abdelmojeb/TangramFP_course_project_and_thesis/Thesis/Screenshot 2025-09-23 221511.png

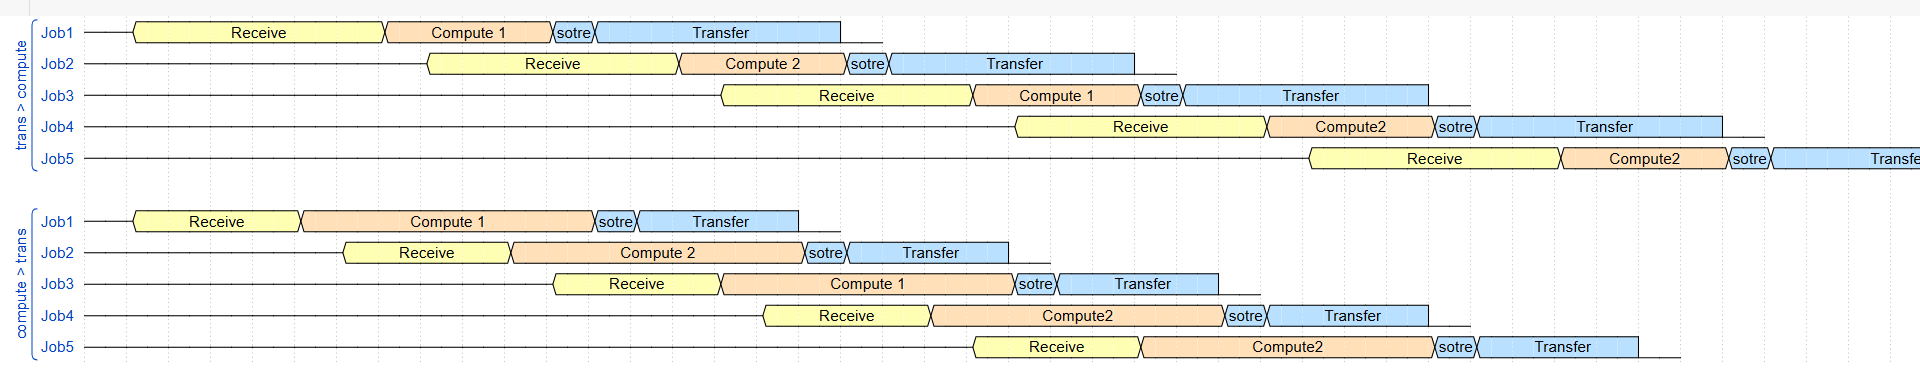
Thesis/Screenshot 2025-09-23 221511.png
