abdelmojeb/TangramFP_course_project_and_thesis/ATES_course/HW_implementation/MAC_results.txt

Time first input: 15000 ps
Time second input: 25000 ps
Time: 35000 ps
clock at: 35000 ps
a:= -1.465743e+12
b:= -1.643155e-32
c:= -1.806668e-20
success 1
actual:= 6.017749e-21
expected:= 6.017749e-21
a: 00110111111100110111111111101100
b: 00001001111100110111111111101110
c: 00000001111100110111111111101010
actual FP32 : 00011101111000110101100000011001

clock at: 45000 ps
a:= -2.506475e-16
b:= 9.790921e-19
c:= -2.174021e-34
success 2
actual:= -4.628091e-34
expected:= -4.628091e-34
a: 10100100101011100101110110101100
b: 10011100001011100101110110101100
c: 00000001001011100101110110101010
actual FP32 : 10001000000110011100101101110010

clock at: 55000 ps
a:= 2.902743e-05
b:= 5.862043e-33
c:= 8.944765e-38
success 3
actual:= 2.596076e-37
expected:= 2.596077e-37
a: 10111010000111111000011100000010
b: 01000001100111111000011100000100
c: 10111100000111111000011100000001
actual FP32 : 00000010101100001010111000001000

clock at: 65000 ps
a:= -7.561916e-17
b:= -5.769284e-22
c:= 3.202595e-38
success 4
actual:= 7.565279e-38
expected:= 7.565279e-38
a: 10100110101101010000010101110111
b: 10011010001101010000010101110111
c: 00000001001101010000010101110110
actual FP32 : 00000001110011011111001001001101

clock at: 75000 ps
a:= -6.085486e-04
b:= 1.994093e+01
c:= -9.736777e-03
success 5
actual:= -2.187180e-02
expected:= -2.187180e-02
a: 11010111001010101100100101010100
b: 11011101001010101100100101010101
c: 01110100101010101100100101010010
actual FP32 : 10111100101100110010110001111101

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

clock at: 995000 ps
a:= 2.544192e-36
b:= 4.088359e+24
c:= 6.151477e-12
success 97
actual:= 1.655305e-11
expected:= 1.655305e-11
a: 11011010001001101010011111010010
b: 10000001101001101010011111010010
c: 00011100001001101010011111010000
actual FP32 : 00101101100100011001101000100101
