abdelmojeb/TangramFP_course_project_and_thesis/Thesis/systolic_array_on_Zynq7000_Minized/my_package.vhd

library IEEE;
use IEEE.STD_LOGIC_1164.ALL;
use IEEE.NUMERIC_STD.ALL;
package my_types is 
    constant N : integer := 2;
    constant Pre_in: integer :=16;
    constant ex_width_in : integer := 5;
    constant cut : integer := 5;
    constant offset : integer range 0 to 32 := 0;
    
    constant Pre_out : integer := Pre_in*2;
    constant ex_width_out: integer range 0 to 16:=ex_width_in+3;
    constant man_width_in: integer range 0 to 32:= Pre_in-ex_width_in -1;
    constant man_width_out: integer range 0 to 64:= Pre_out-ex_width_out -1;
    constant thr1: integer := cut;
    constant thr2 : integer := man_width_in;
    
    type mode_array is array (0 to N-1)  of std_logic_vector(2*N-1 downto 0);
    type N_N_prein is array (0 to N-1, 0 to N-1) of std_logic_vector(Pre_in-1 downto 0);
    type N_N_preout is array (0 to N-1, 0 to N-1) of std_logic_vector(Pre_out-1 downto 0);
    type N_1_prein is array ( 0 to N-1) of std_logic_vector(Pre_in-1 downto 0);
    type N_1_preout is array ( 0 to N-1) of std_logic_vector(Pre_out-1 downto 0);
    type A_pipeline is array (0 to N-1, 0 to N-2) of std_logic_vector(Pre_in-1 downto 0);
    type max_array is array (0 to N-1) of unsigned(ex_width_in downto 0);
    type exp_array is array  (0 to N-1,0 to N-1) of unsigned(ex_width_in downto 0); 
    type N_1_mode is array (0 to N-1) of std_logic_vector(N*(N+1)-1 downto 0);
end package;
