abdelmojeb/TangramFP_course_project_and_thesis/ATES_course/hw_starter/tb/DaddaMultiplier_TestBench.vhd

library ieee;
use ieee.std_logic_1164.all;
use ieee.numeric_std.all;

entity testbench is
end testbench;

architecture behavior of testbench is
	component DaddaMultiplier
		generic(n : integer := 5);
		port(
			a : in std_logic_vector(n - 1 downto 0);
			b : in std_logic_vector(n - 1 downto 0);
			is_signed : in std_logic;
			result : out std_logic_vector(2 * n - 1 downto 0)
		);
	end component;

	signal op1 : std_logic_vector(4 downto 0) := "11111";
	signal op2 : std_logic_vector(4 downto 0) := "11111";
	signal result : std_logic_vector(9 downto 0);

begin
	uut: DaddaMultiplier port map(a => op1, b => op2, is_signed => '0', result => result );

	tb : process
	begin
		op1 <= "11101";
		op2 <= "10111";
		wait for 100 ns;
		op1 <= "11111";
		op2 <= "11111";
		wait;
	end process;
end;
